pvedu/agripv/images/image12.png

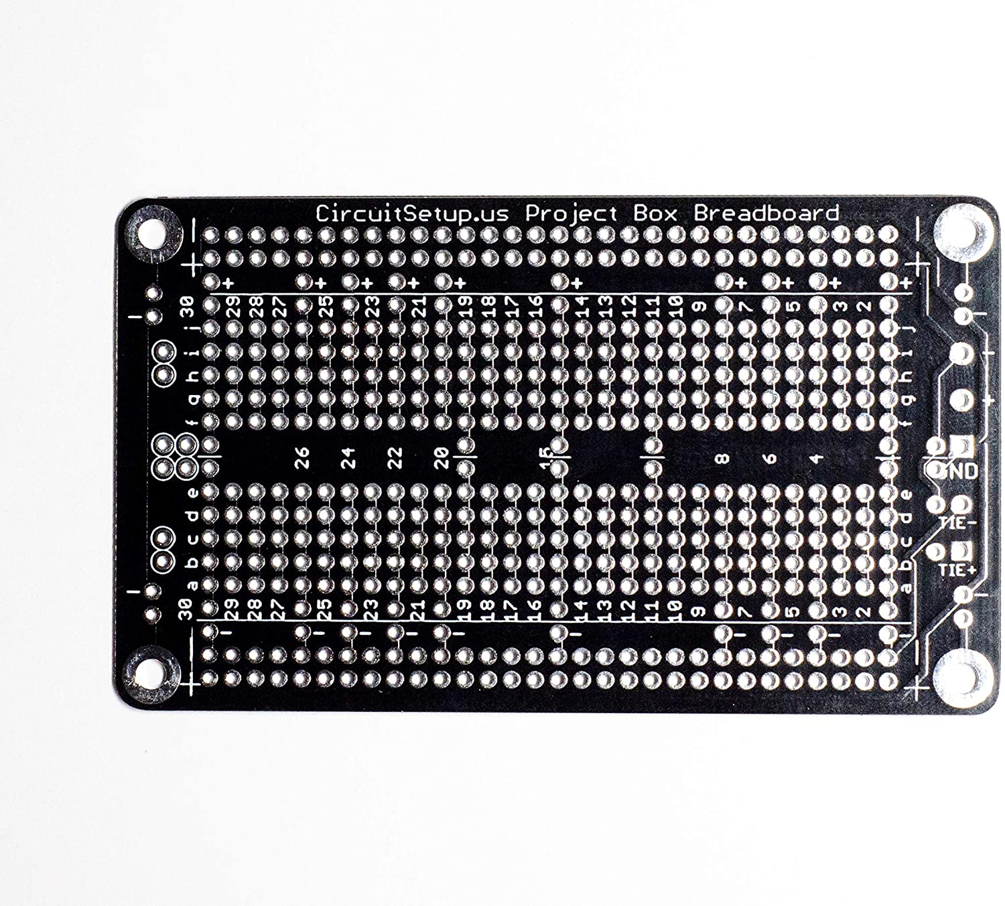
images/image12.png
