pvedu/agripv/images/image24.png

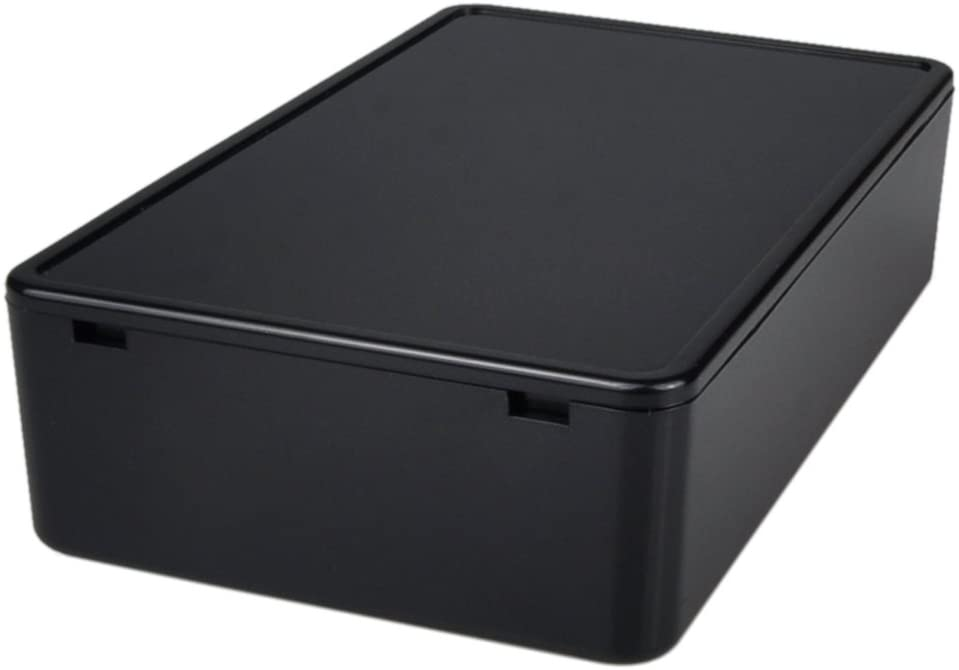
images/image24.png
