pvedu/agripv/images/image27.png

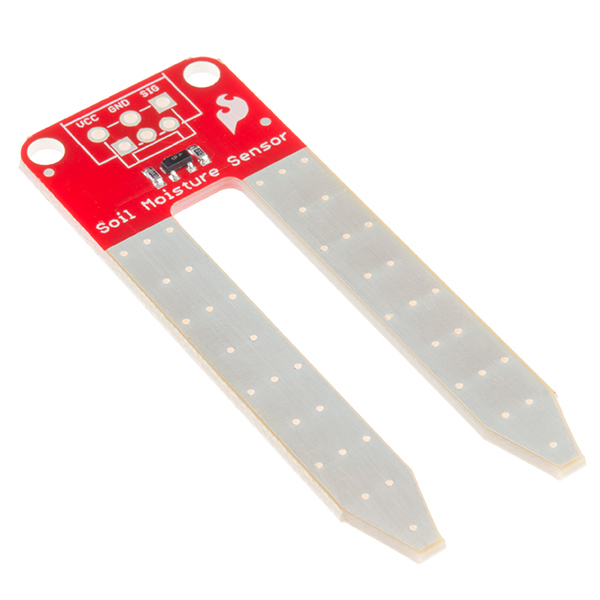
images/image27.png
