pvedu/agripv/images/image28.png

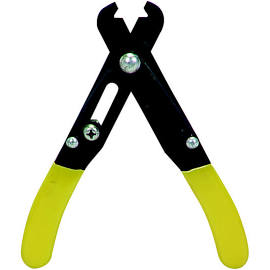
images/image28.png
