pvedu/agripv/images/image30.png

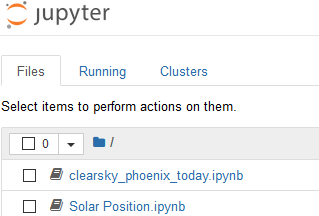
images/image30.png
