pvedu/agripv/images/image31.png

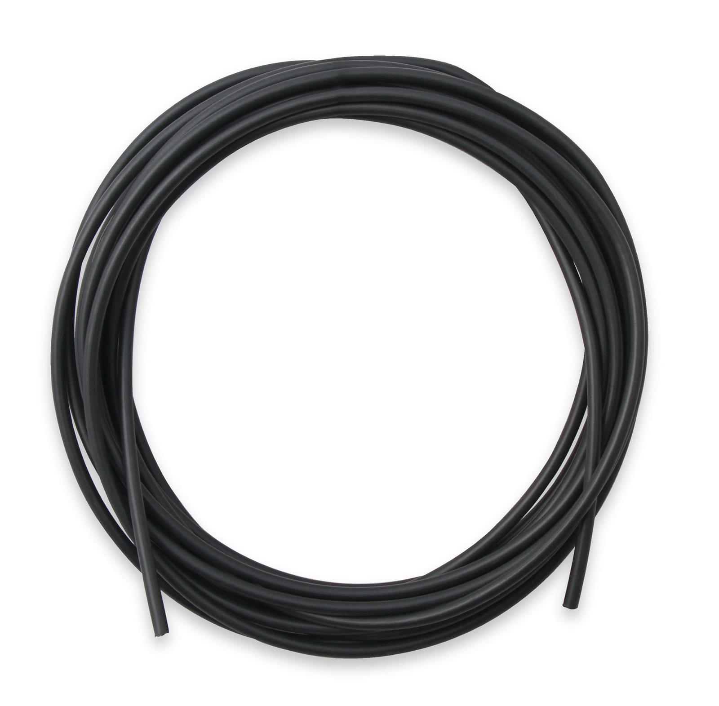
images/image31.png
