pvedu/agripv/images/image32.jpg

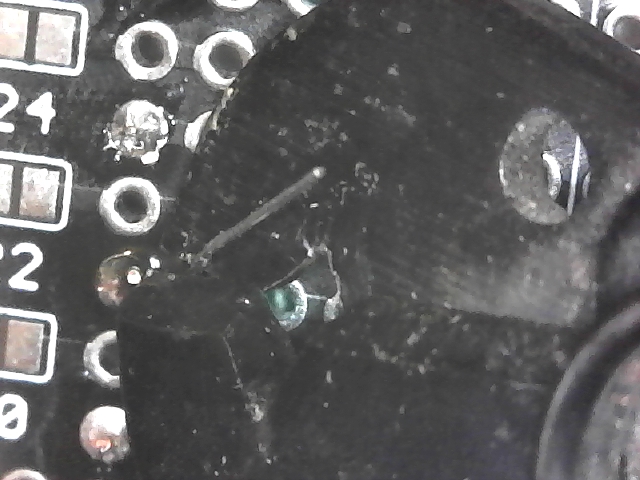
images/image32.jpg
