pvedu/agripv/images/image35.png

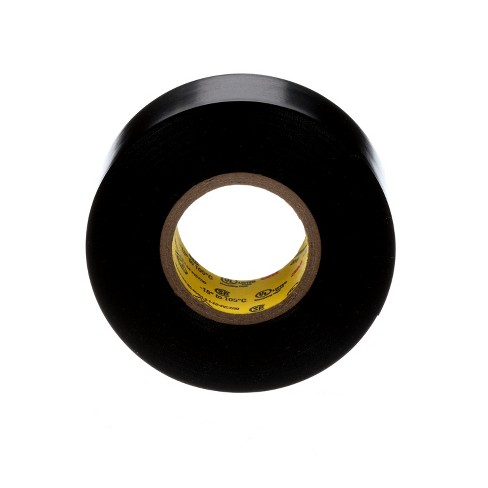
images/image35.png
