pvedu/agripv/images/image37.png

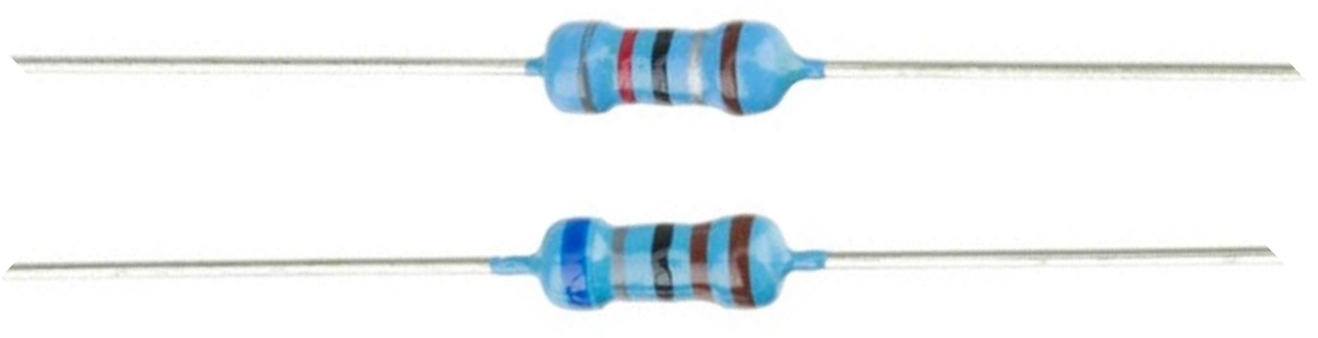
images/image37.png
