pvedu/agripv/images/image39.png

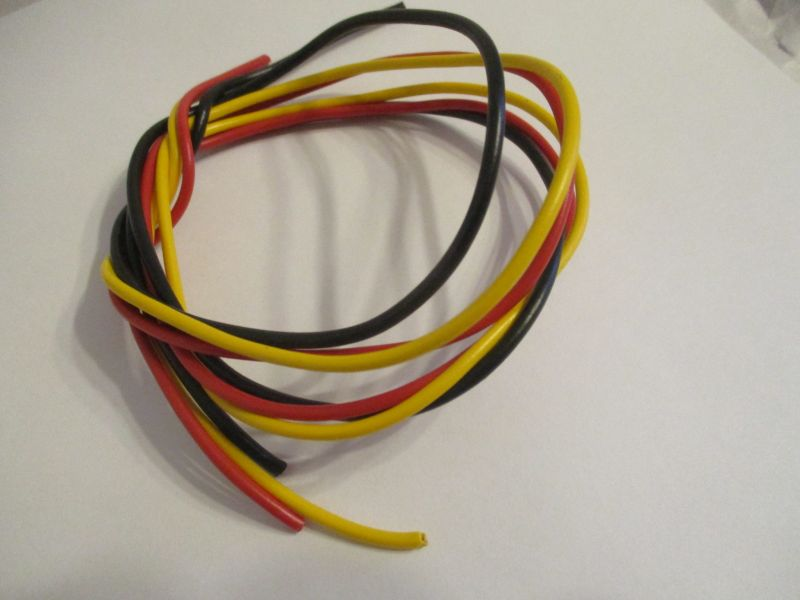
images/image39.png
