pvedu/agripv/images/image45.png

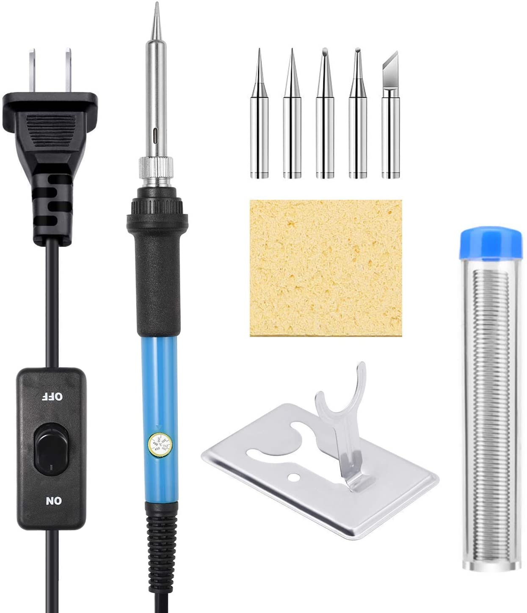
images/image45.png
