pvedu/agripv/images/image56.png

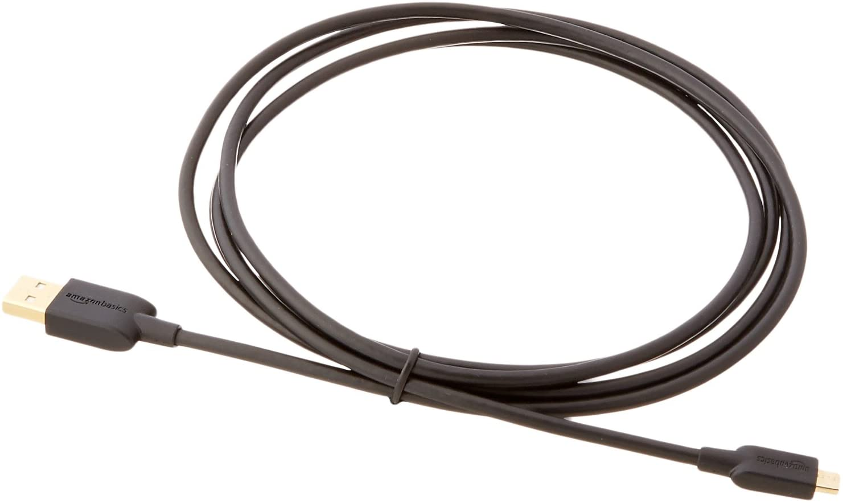
images/image56.png
