pvedu/agripv/images/image57.png

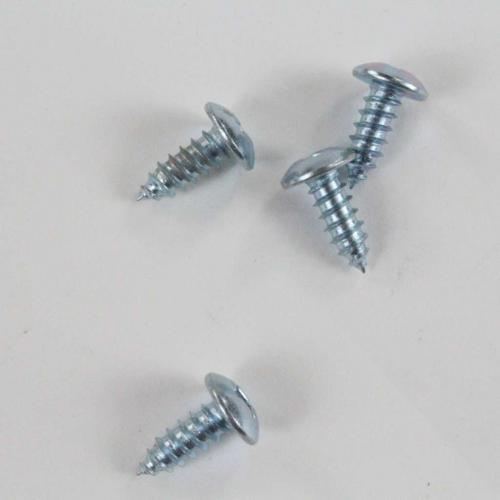
images/image57.png
