pvedu/agripv/images/image58.png

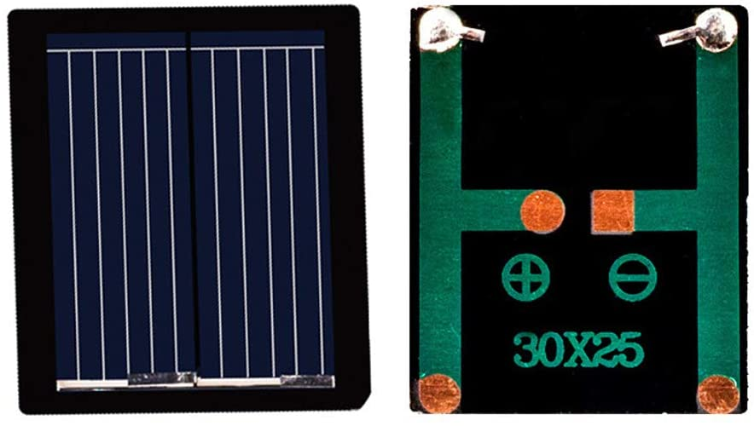
images/image58.png
