pvedu/agripv/images/image59.jpg

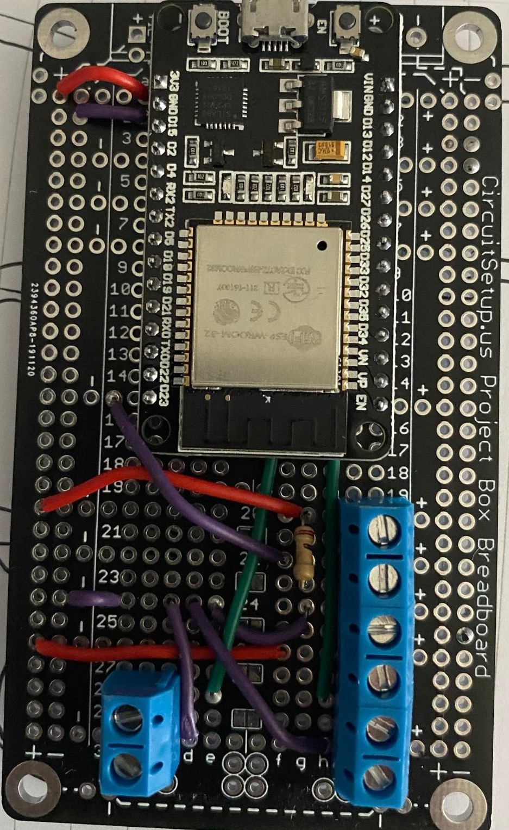
images/image59.jpg
