pvedu/agripv/images/image62.png

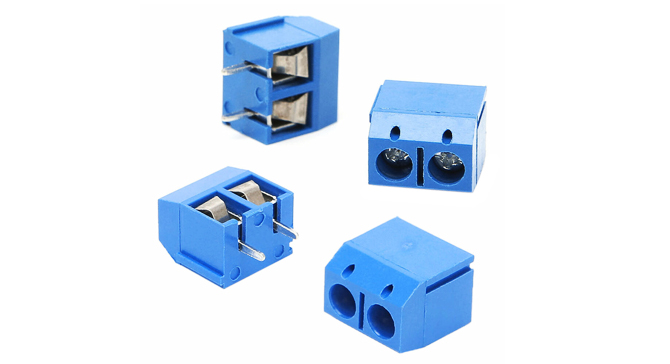
images/image62.png
