pvedu/agripv/images/image63.png

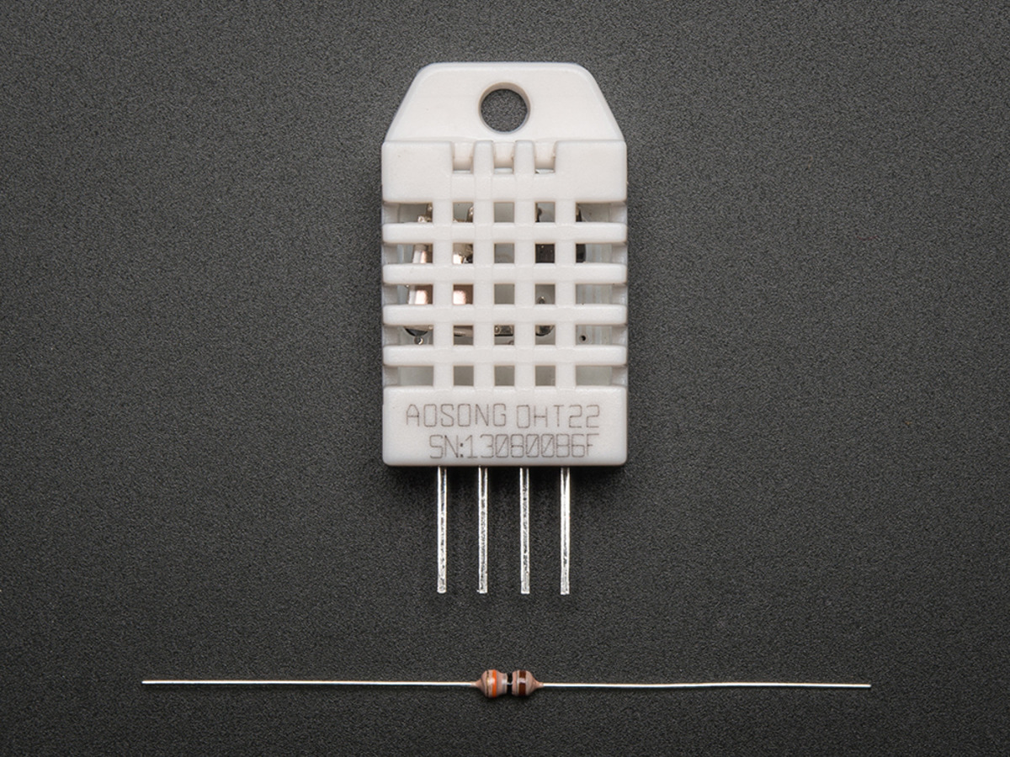
images/image63.png
