pvedu/agripv/images/image64.png

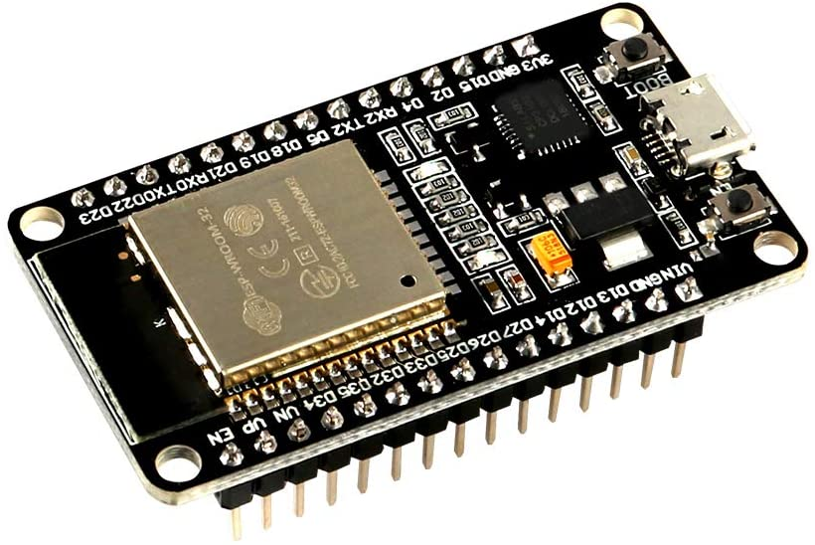
images/image64.png
